techstudycell/ESP32-Alexa-Home-Automation-with-Fan-Dimmer/Picture/required components for ESP32 Project.png

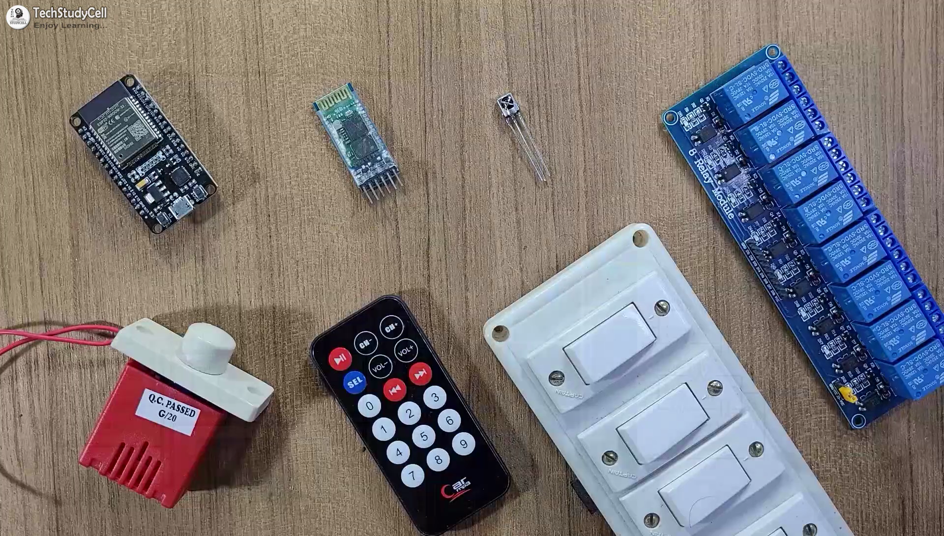
Picture/required components for ESP32 Project.png
