techstudycell/ESP32-Alexa-Home-Automation-with-Fan-Dimmer/Circuit/Circuit of the ESP32 IoT Project.png

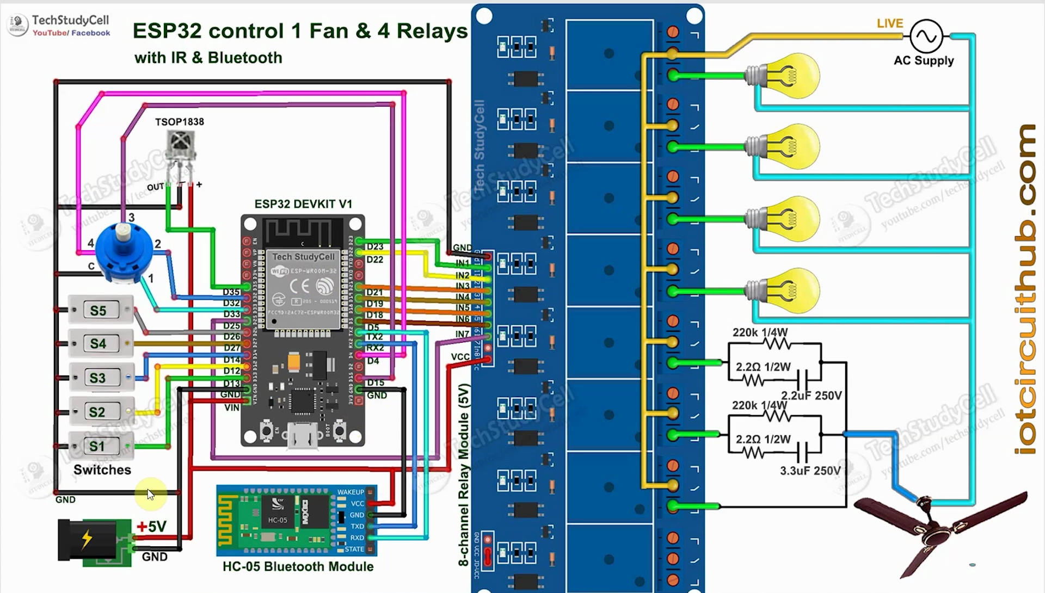
Circuit/Circuit of the ESP32 IoT Project.png
