techstudycell/ESP32-Alexa-Home-Automation-with-Fan-Dimmer/Circuit/connection for PCB V3.png

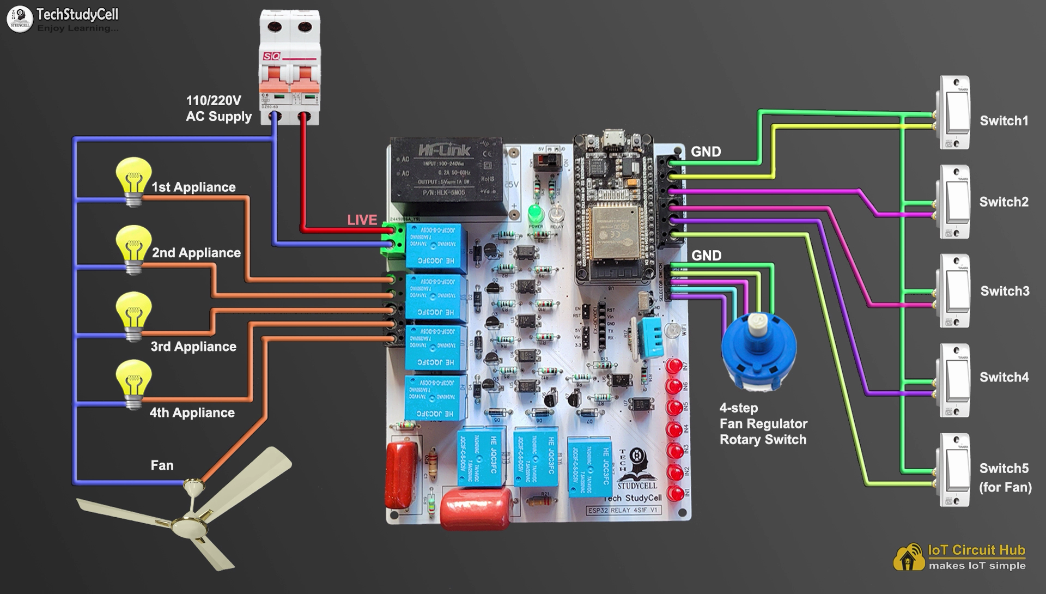
Circuit/connection for PCB V3.png
