techstudycell/ESP32-Alexa-Home-Automation-with-Fan-Dimmer/Picture/ESP32 Alexa Home Automation p1.png

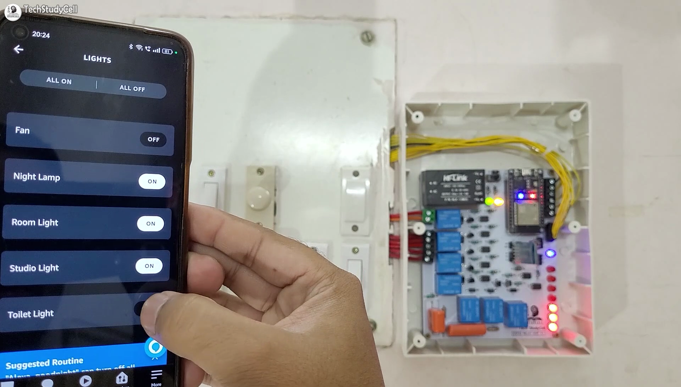
Picture/ESP32 Alexa Home Automation p1.png
