techstudycell/ESP32-Alexa-Home-Automation-with-Fan-Dimmer/Picture/ESP32 Alexa Home Automation p7.png

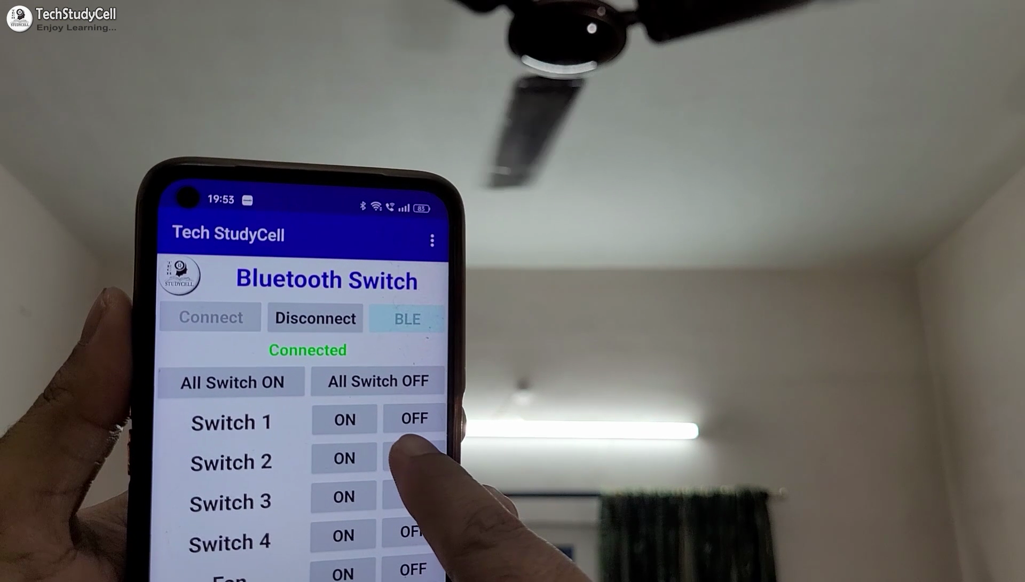
Picture/ESP32 Alexa Home Automation p7.png
