techstudycell/ESP32-Alexa-Home-Automation-with-Fan-Dimmer/Picture/ESP32 PCB V3 p3.png

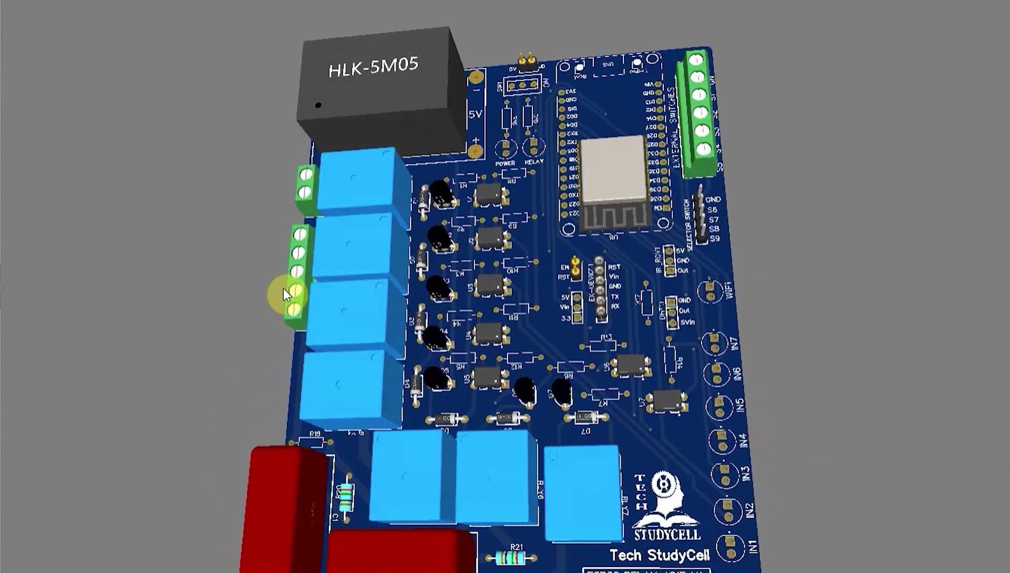
Picture/ESP32 PCB V3 p3.png
